kosa215/DIY-Saab-9-3-Tachometer/code/media_called_by_python/all_but_needle.png

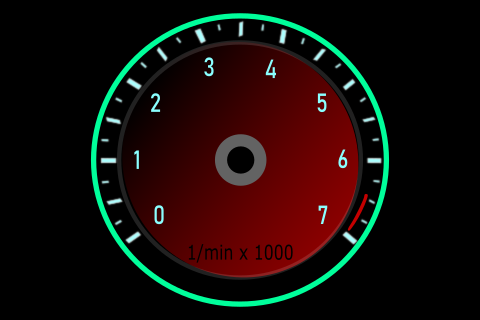
code/media_called_by_python/all_but_needle.png
