kosa215/DIY-Saab-9-3-Tachometer/code/media_called_by_python/needle_outlined.png

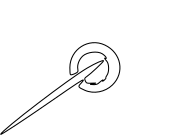
code/media_called_by_python/needle_outlined.png
