kosa215/DIY-Saab-9-3-Tachometer/images/saab_exterior.jpg

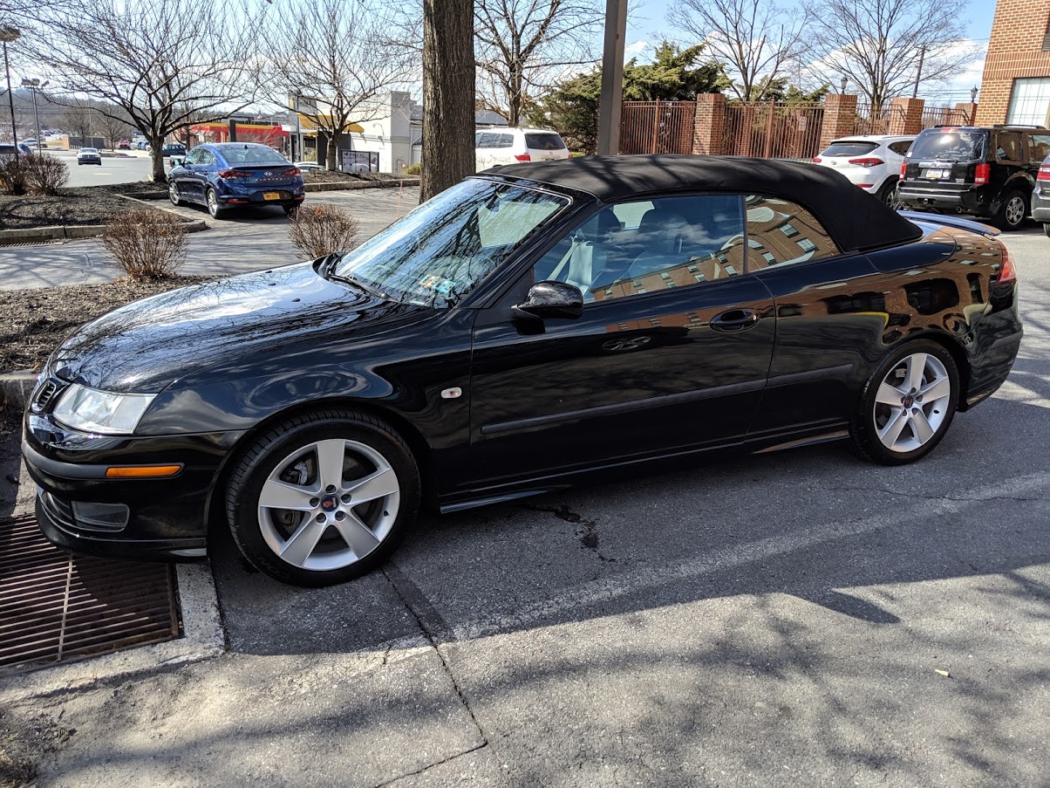
images/saab_exterior.jpg
